csvancea/fire-alarm/docs/img/fire-alarm-phone-notification-2.png

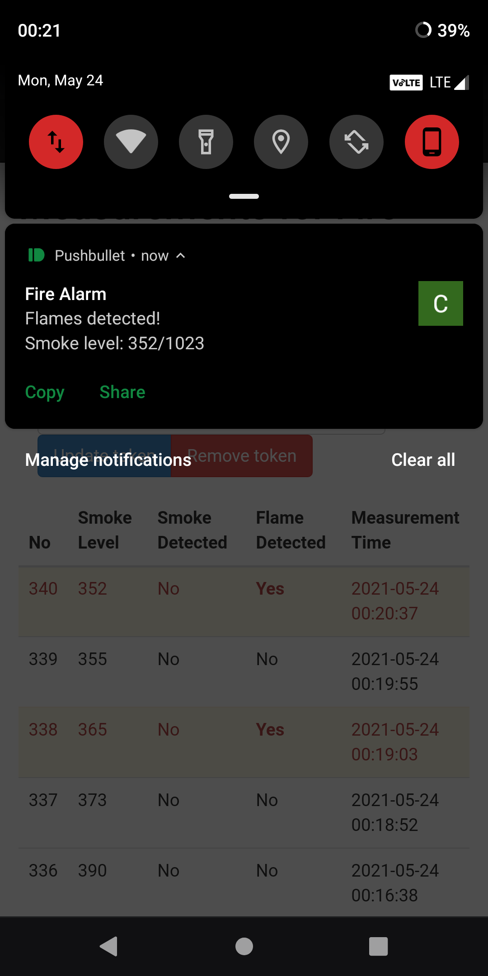
docs/img/fire-alarm-phone-notification-2.png
