csvancea/fire-alarm/docs/fire-alarm-schema-electrica.sch

## EAGLE design docs/fire-alarm-schema-electrica.sch (2023-05-29)

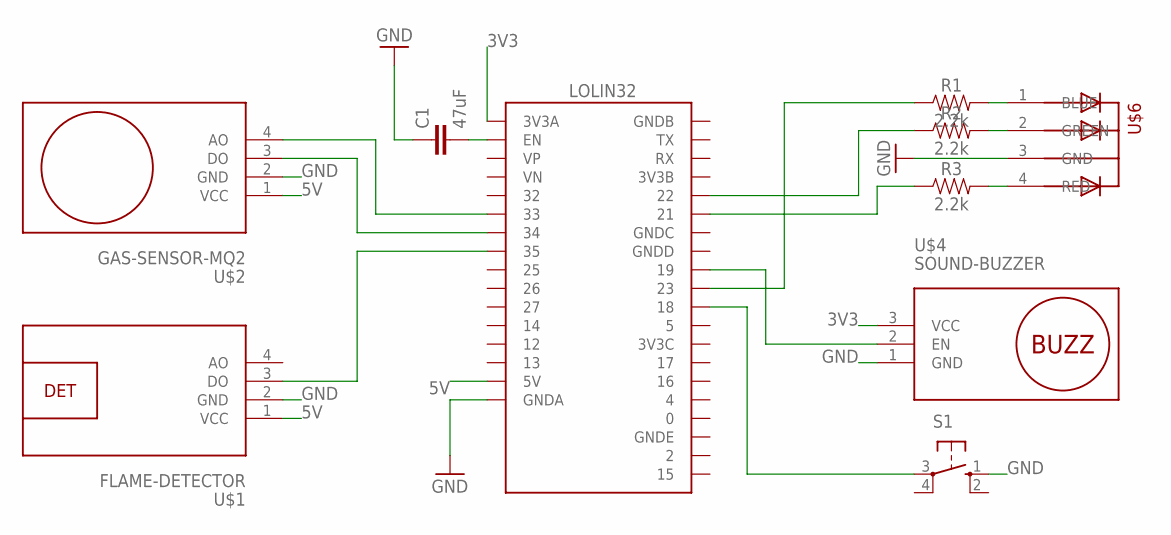
[picture p11: schematic fire-alarm-schema-electrica.sch]

Parts:
C1: 47uF; 0603
LOLIN32: SSFD_LOLIN32_WEMOS_CHINA_W_BATT
R1, R2, R3: 2.2k; 0603
S1: 10-XX; B3F-10XX
U$1: FLAME-DETECTOR
U$2: GAS-SENSOR-MQ2
U$4: SOUND-BUZZER
U$6: 5MMRGBLED; LED5MMRGB

Connections:
3V3: LOLIN32.3V3A, U$4.3 (VCC)
5V: LOLIN32.5V, U$1.1 (VCC), U$2.1 (VCC)
GND: C1.1, LOLIN32.GNDA, S1.1 (S), U$1.2 (GND), U$2.2 (GND), U$4.1 (GND), U$6.3 (GND)
unnamed: LOLIN32.21, R3.1
unnamed: LOLIN32.22, R2.1
unnamed: LOLIN32.33, U$2.4 (AO)
unnamed: LOLIN32.34, U$2.3 (DO)
unnamed: LOLIN32.23, R1.1
unnamed: R1.2, U$6.1 (BLUE)
unnamed: R2.2, U$6.2 (GREEN)
unnamed: LOLIN32.19, U$4.2 (EN)
unnamed: LOLIN32.18, S1.3
unnamed: C1.2, LOLIN32.EN
unnamed: LOLIN32.35, U$1.3 (DO)
unnamed: R3.2, U$6.4 (RED)
