csvancea/fire-alarm/fire-alarm/src/Pins.h

#pragma once

#define PIN_MQ2_GAS_A  33
#define PIN_MQ2_GAS_D  34
#define PIN_IR_FLAME   35
#define PIN_BUZZER     19
#define PIN_BUTTON     18

#define PIN_RGBLED_R   21
#define PIN_RGBLED_G   22
#define PIN_RGBLED_B   23
