csvancea/fire-alarm/(commit log)

2021-05-01 Disable SD Card; Added RGB LED for error signalling
2021-05-01 Read sensors
2021-05-02 Fix multiplication overflow; change gas sensor threshold
2021-05-02 Print a meaningful message when an error is encountered during startup
2021-05-02 Try to auto reestablish the connection to AP if lost; Implement better error signalling via LED and messages
2021-05-03 Activate buzzer on IR sensor interrupt
2021-05-03 Hook up gas sensor to the buzzer alarm
2021-05-03 Implement async ADC class
2021-05-03 Start async ADC when gas is detected
2021-05-03 Move Arduino project to its own subfolder
2021-05-03 Add simple-server project (listens for sensor messages)
2021-05-04 Revert "Add simple-server project (listens for sensor messages)"
    This reverts commit 5ba94161045d154a49debd5a37951d996fc64af9.
2021-05-04 Send sensor data using POST requests
2021-05-24 Added README.md + docs
    [fire-alarm-schema-electrica.sch]
2023-05-22 Howl: Adapt the API to the Arduino codebase changes
2023-05-22 Arduino: Switch to ESP32
2023-05-23 Arduino: Add a ping endpoint to validate the connection to the configuration SoftAP
2023-05-28 Arduino: Use correct type for `millis()`
    [FireAlarm.cpp, FireAlarm.h, Led.cpp, Led.h]
2023-05-28 Arduino: Rate limit the number of positive POST requests
2023-05-29 Docs: Update the IoT project documentation
    [fire-alarm-schema-electrica.sch]
